OpenSourceSDRLab/ZYNQ7020-FMC/hardware/ZYNQ7020-FMC_Carrier_Schematic.pdf

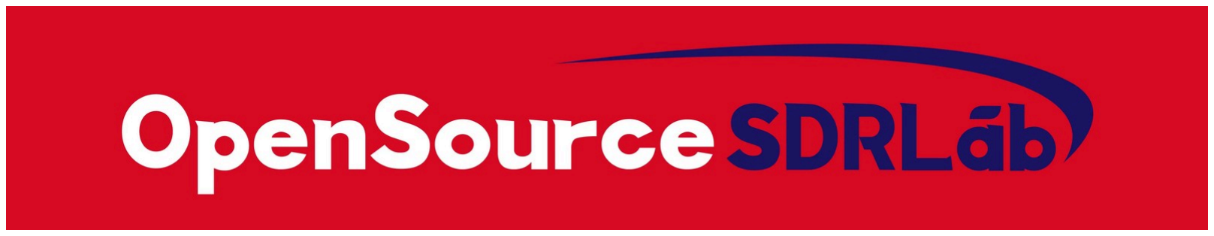
[picture p8: figure]

## © 2026 OpenSourceSDRLab. All rights reserved. · www.opensourcesdrlab.com

# OPENSOURCESDRLAB DOCUMENTATION

# ZYNQ7020-FMC Carrier Board Schematic

Product | ZYNQ7020-FMC
Document | OSSDRLAB-ZYNQ7020-FMC-SCH-CARRIER
Version | 1.1
Date | 2026-11-12

This document contains the circuit schematic of the OpenSourceSDRLab ZYNQ7020-FMC carrier board (revision V1.1), exported from Altium Designer (A4). The seven schematic sheets follow this cover page.

Sheet | Content
1 | Board-to-board connectors to the ZYNQ7020 core module (2 × 120-pin)
2 | Power: 12 V DC input jack, input protection, MP2225 and MP2145 buck regulators, FMC and I/O-bank supplies
3 | USB 2.0 OTG: USB3320C ULPI PHY, 24 MHz crystal, USB Type-C connector, TPS2051B VBUS switch
4 | Gigabit Ethernet: RTL8211F PHY (RGMII), RJ45 jack with magnetics
5 | microSD card with TXS02612 level translator, 2-position boot-mode switch, MAX809 reset supervisor, reset button, DONE LED
6 | USB-UART (CH340E, USB Type-C) with TXS0102 level translator, JTAG header, 2.54 mm expansion header (PL bank 13)
7 | FMC LPC connector (ASP-134603-01), FMC JTAG and I2C, presence detection

# Repository: https://github.com/OpenSourceSDRLab/ZYNQ7020-FMC

# Questions about the hardware: support@opensourcesdrlab.com

### COJ1

### COJ2

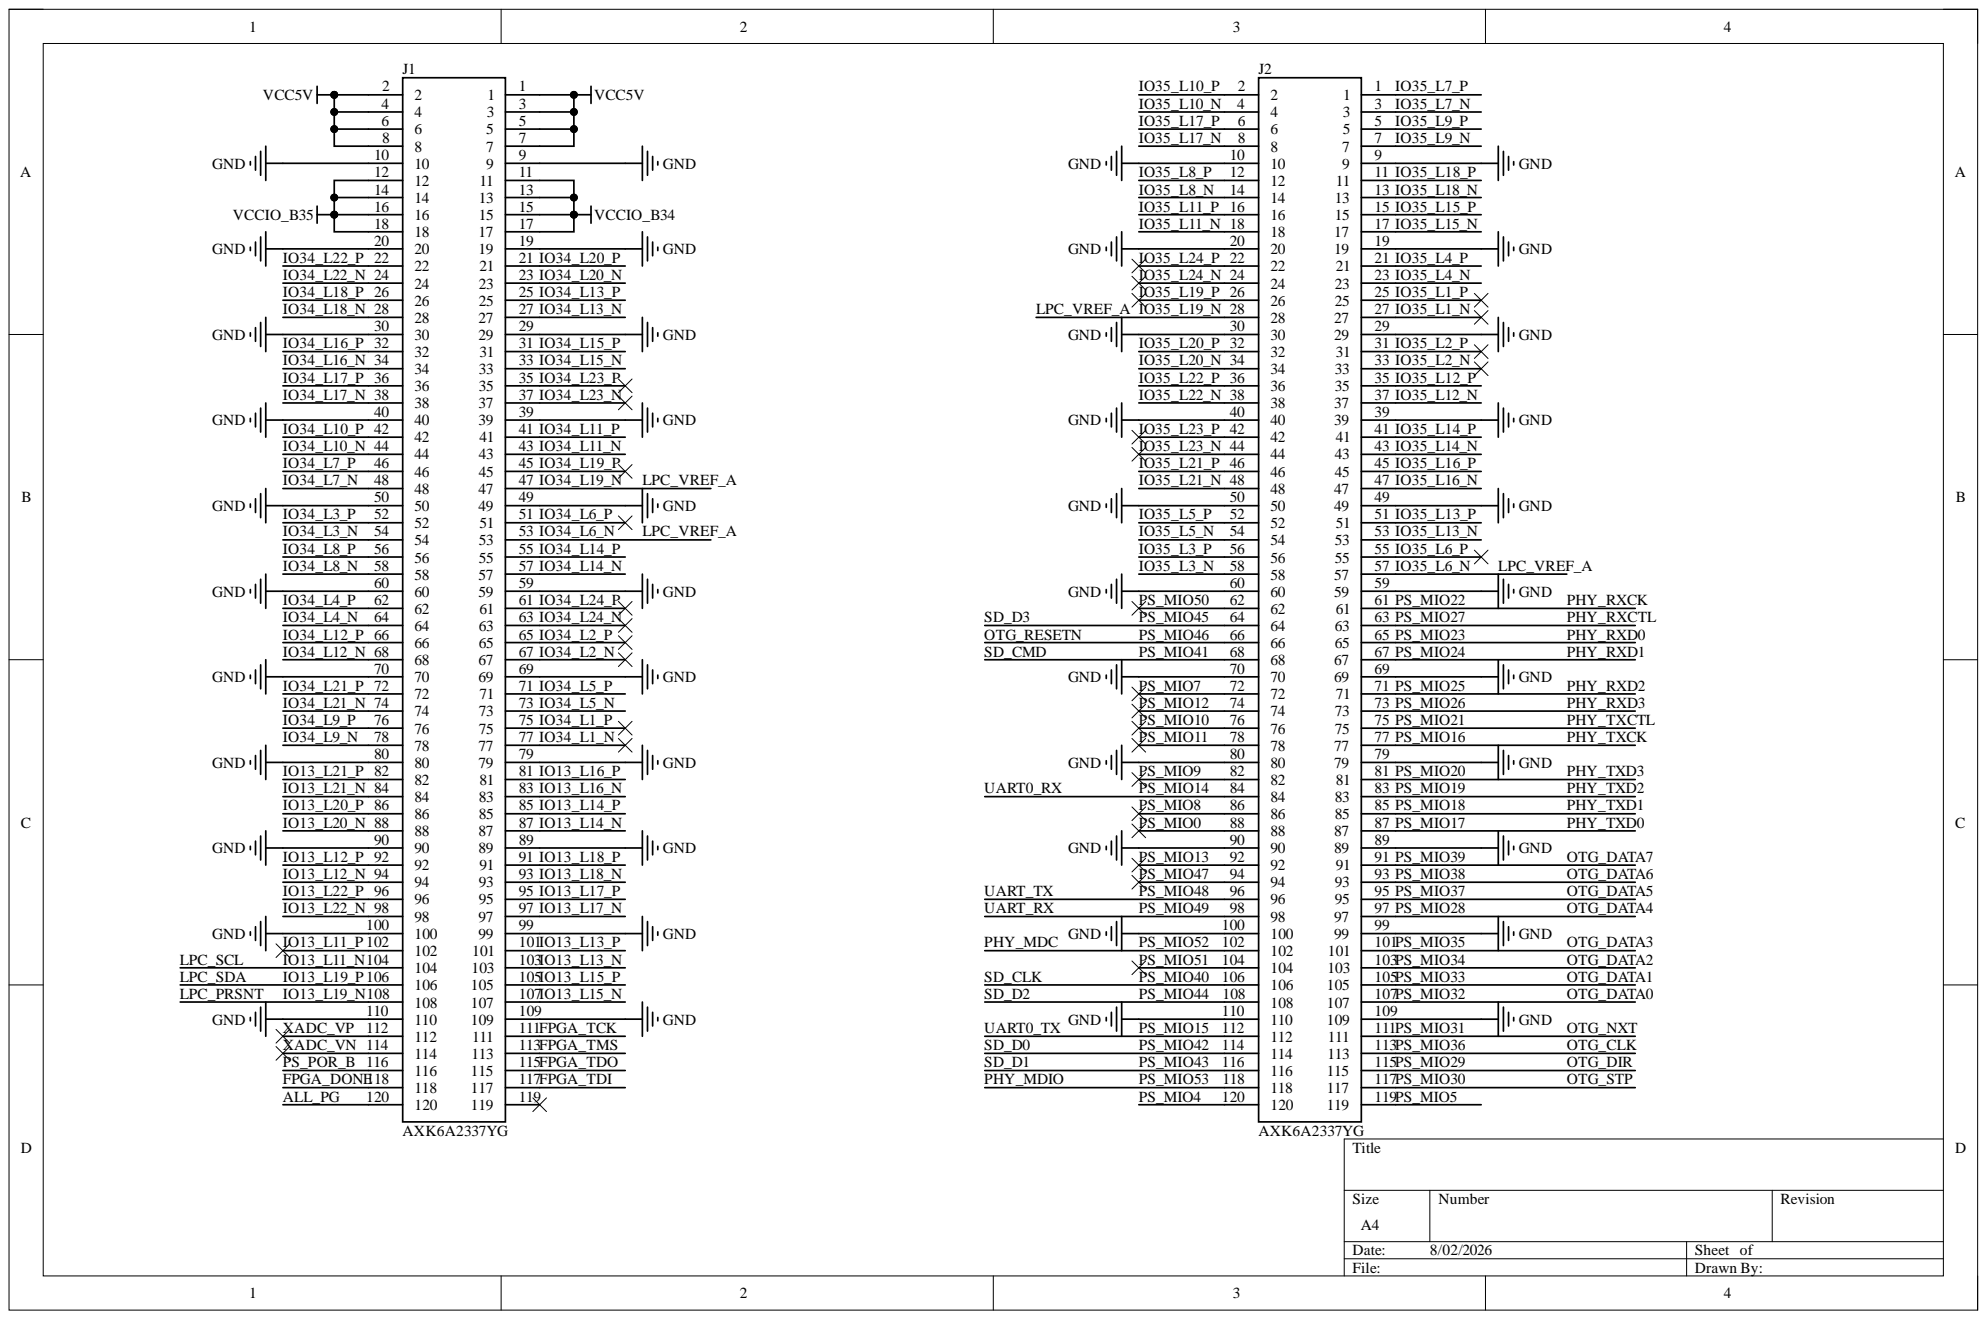
[picture p9: page 2]
Size; umb; Rev; Dat; Sheet; Draw; VCC5; PS_MIO; VCCIO; FPG; TMS; N PS_POR_; 9 PS_MIO; 8 PS_MIO; 7 PS_MIO; _RXCT; ATA; G_RESE; LPC_; VREF_; LPC_PRSN; LPC_SD; LPC_SCL; PIJ102; PIJ101; PIJ104; PIJ103; PIJ106; PIJ105; PIJ108; PIJ107; PIJ1010; PIJ109; PIJ1012; PIJ1011; PIJ1014; PIJ1013; PIJ1016; PIJ1015; PIJ1018; PIJ1017; PIJ1020; PIJ1019; PIJ1022; PIJ1021; PIJ1024; PIJ1023; PIJ1026; PIJ1025; PIJ1028; PIJ1027; PIJ1030; PIJ1029; PIJ1032; PIJ1031; PIJ1034; PIJ1033; PIJ1036; PIJ1035; PIJ1038; PIJ1037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

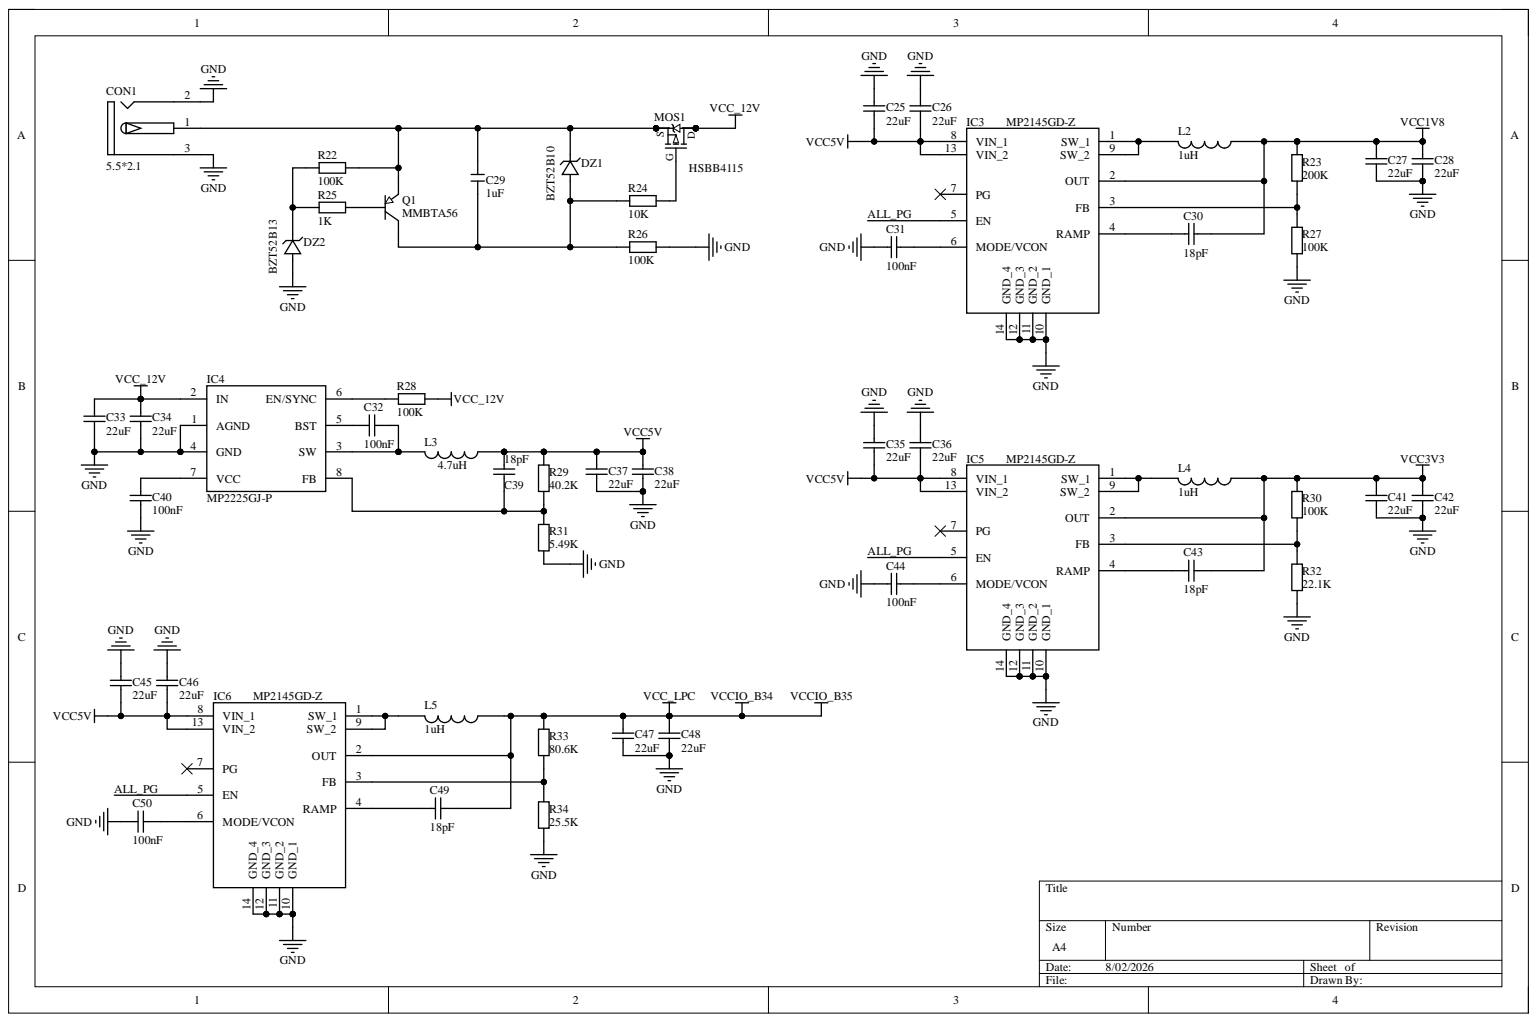
[picture p10: page 3]

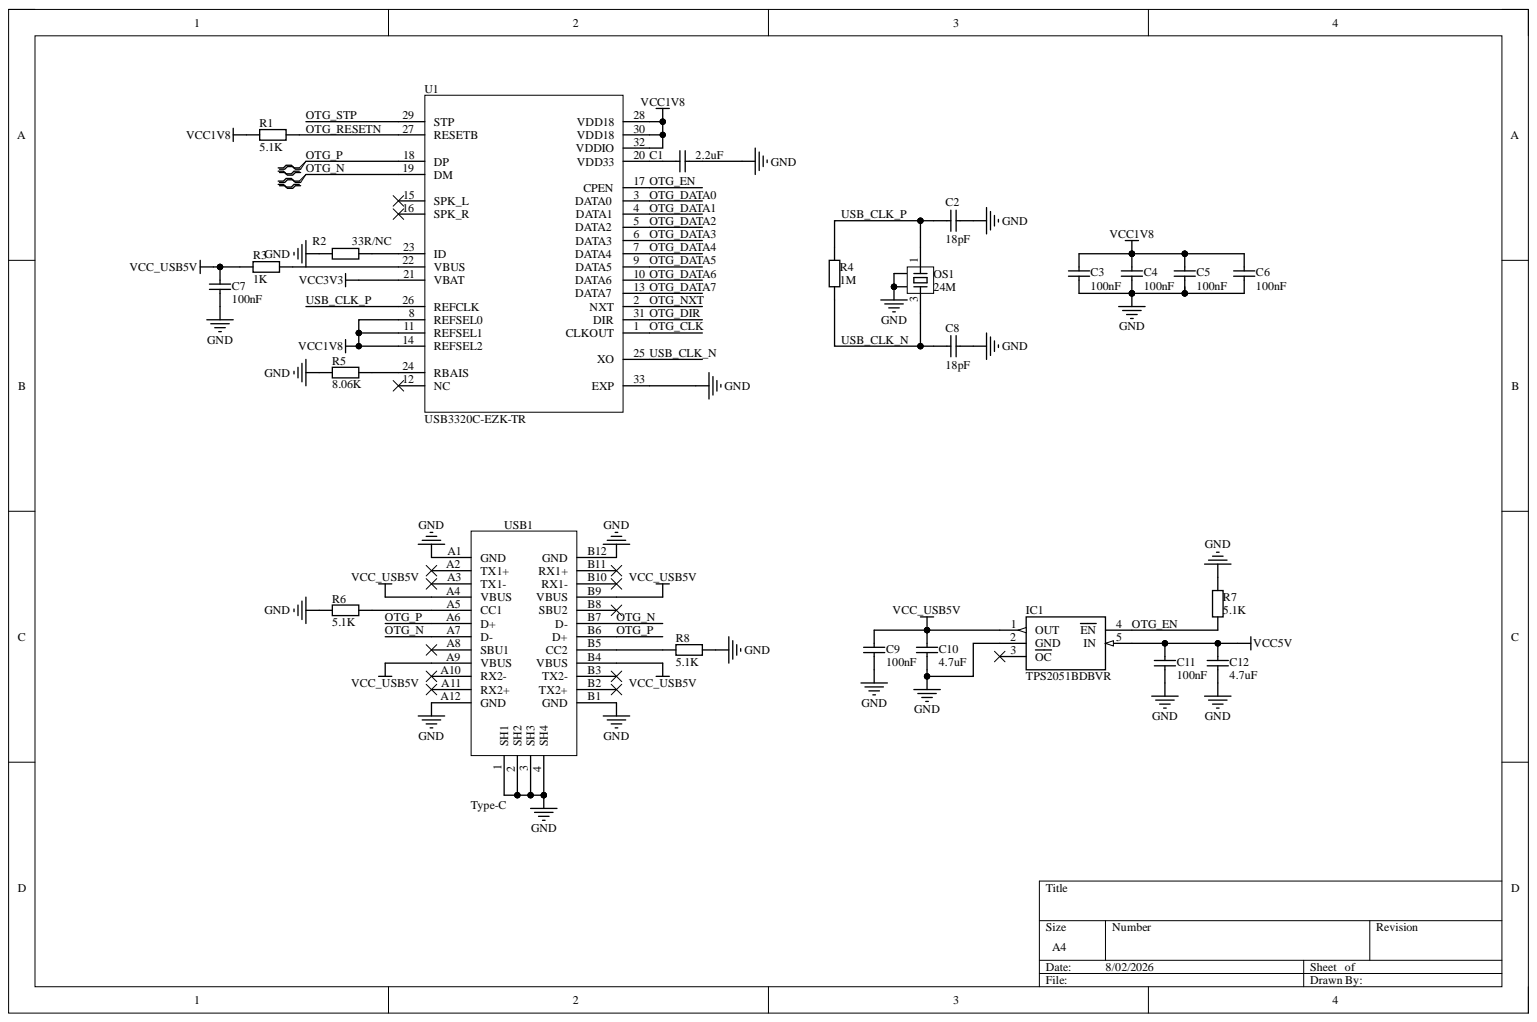
[picture p11: page 4]

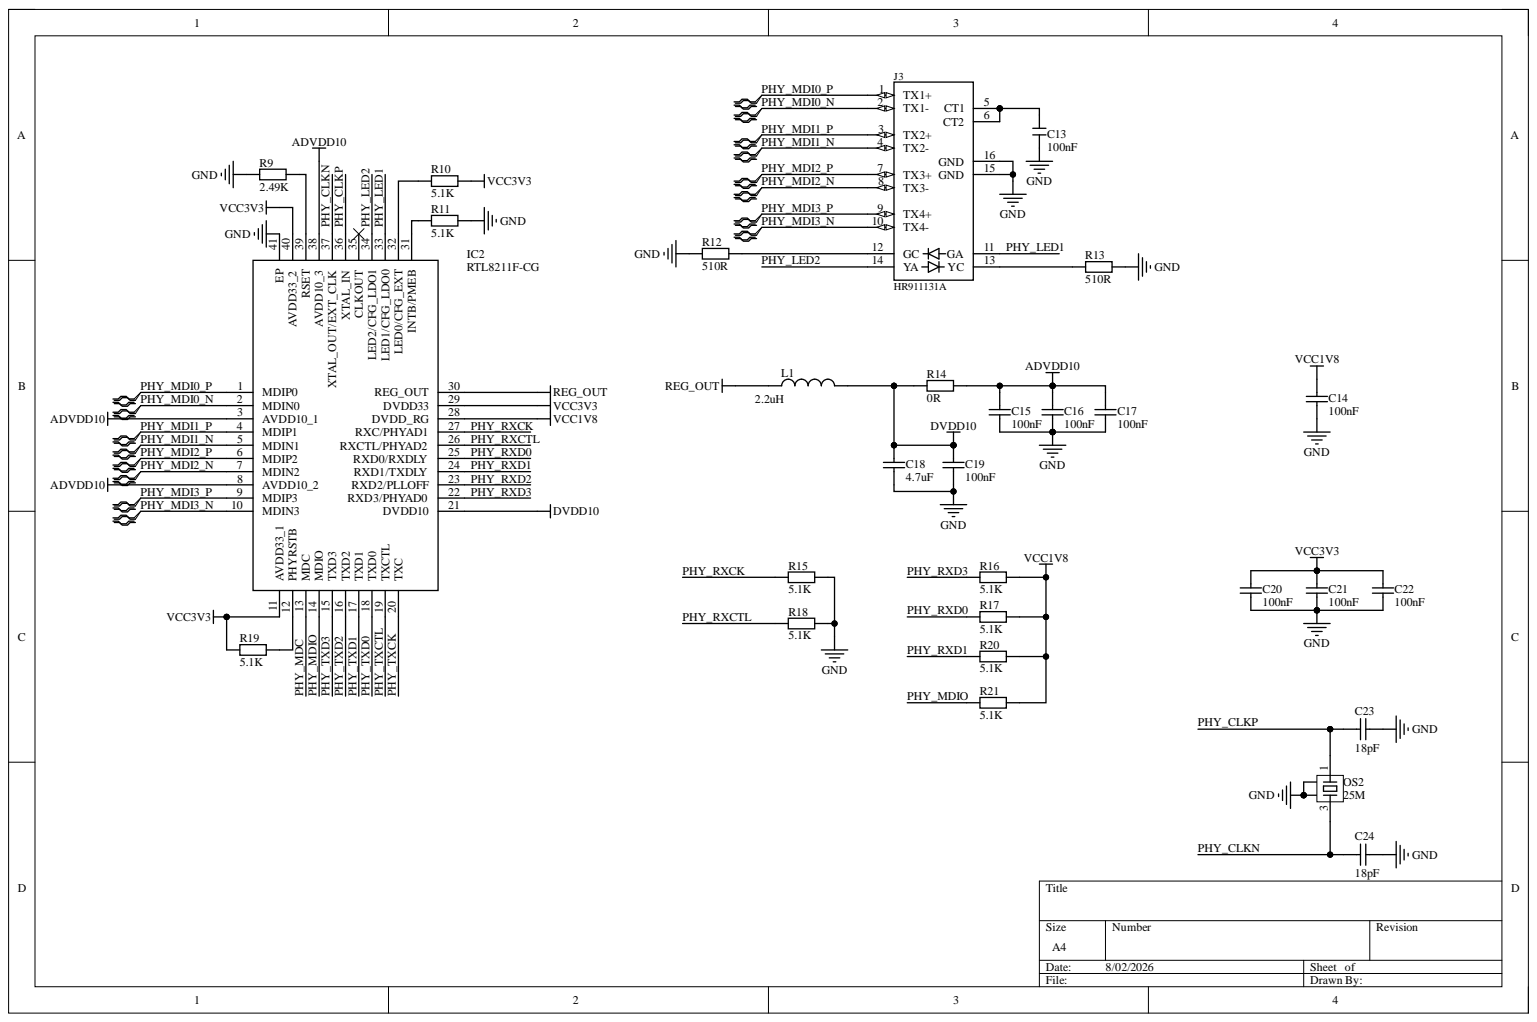
[picture p12: page 5]

## 2-position DIP switch

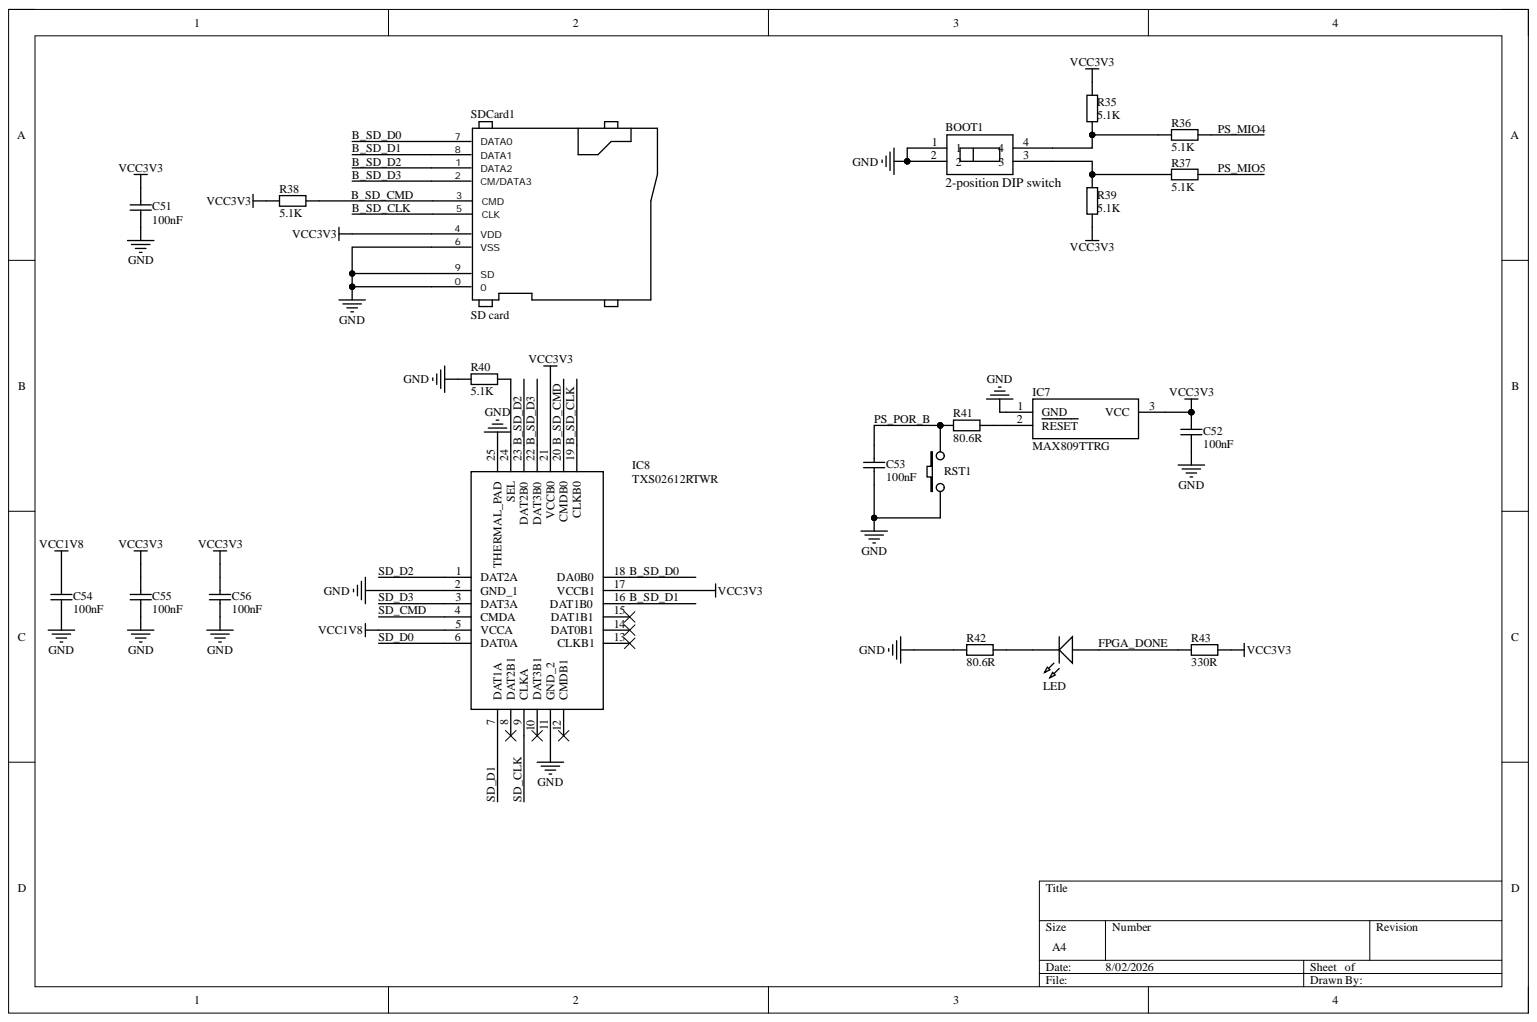
[picture p13: page 6]

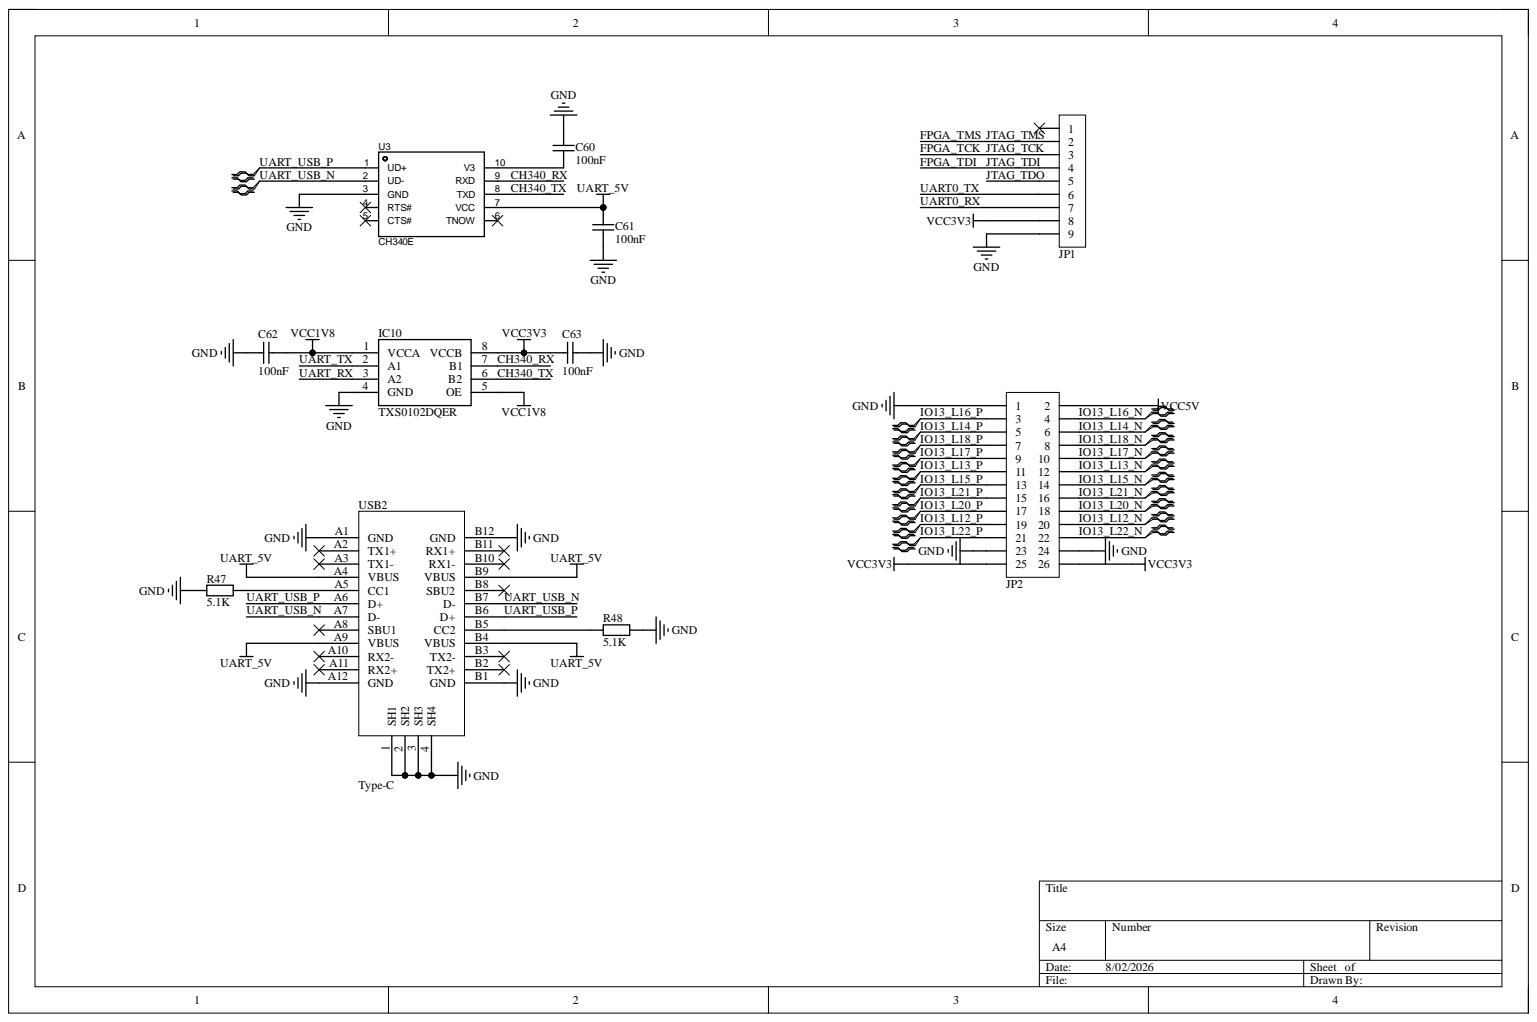
[picture p14: page 7]

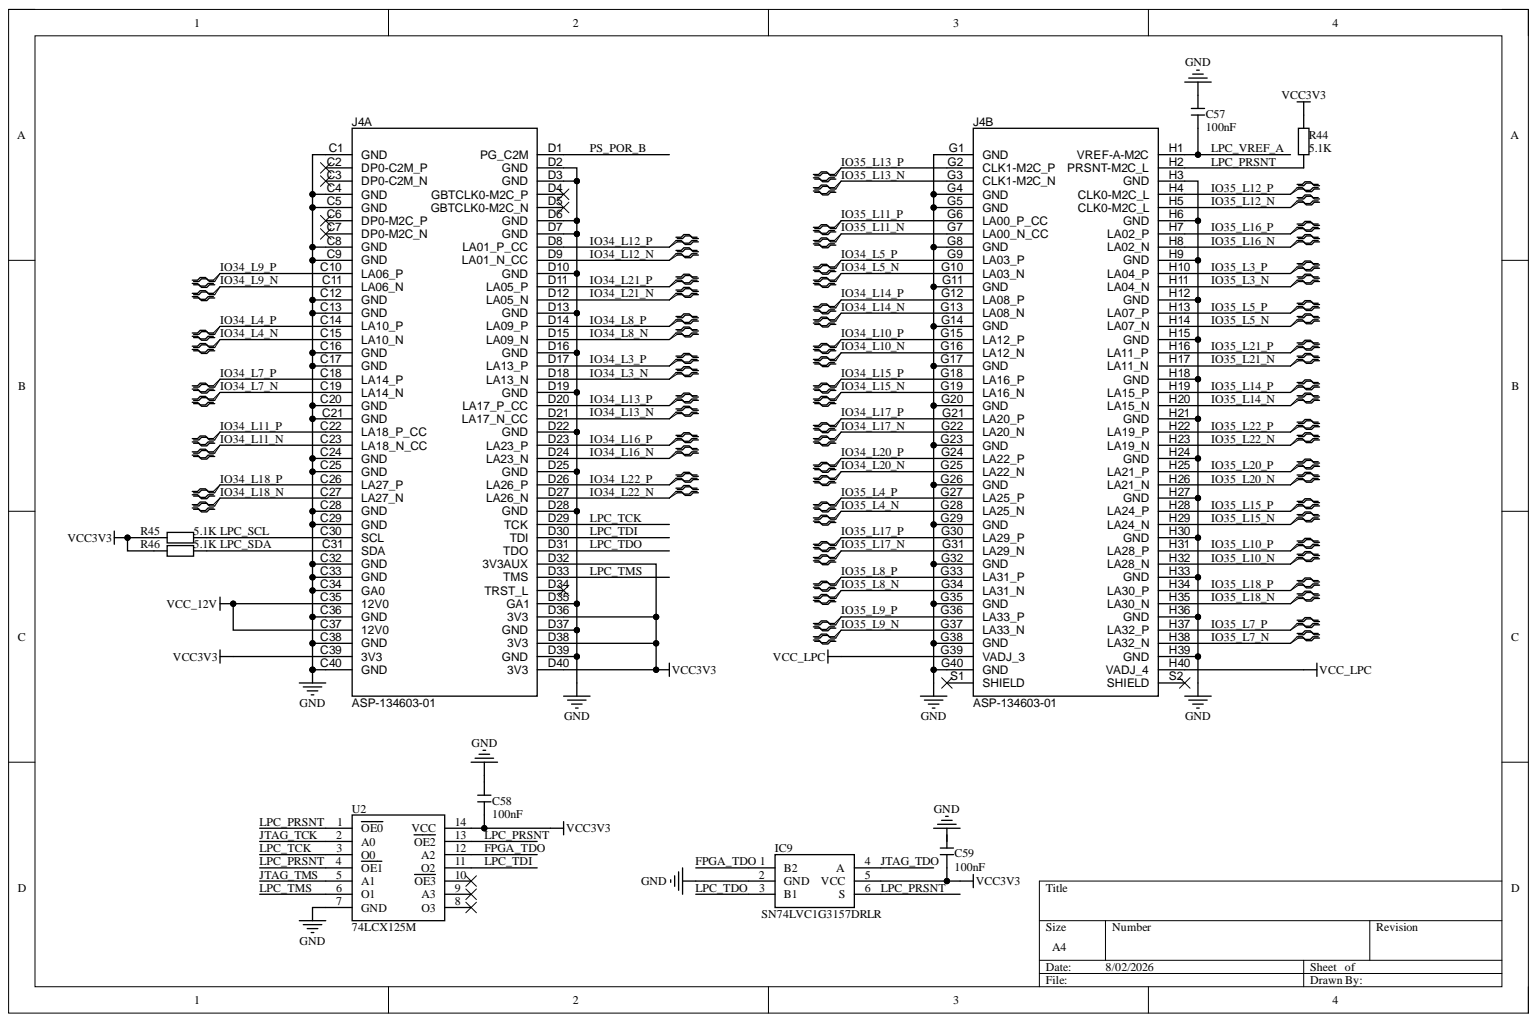
[picture p15: page 8]
Size; umb; Rev; Dat; Sheet; Draw; GBT; CLK0-M2C _; RST_L; ASP-134603-0 1; CLK1-M2C; CLK1-M2C_N G3; VADJ; VREF-A-; PRSN; VAD; PS_POR_; VCC3; LPC_; TMS; TCK; VCC_; LPC_SD; LPC_SCL; VREF_; LPC; LPC_PRSN; VCC; LCX; FPG; LVC1; RLR
