OpenSourceSDRLab/ZYNQ7020-FMC/hardware/ZYNQ7020-FMC_Core-Module_Schematic.pdf

## © 2026 OpenSourceSDRLab. All rights reserved. · www.opensourcesdrlab.com

# OPENSOURCESDRLAB DOCUMENTATION

# ZYNQ7020-FMC Core Module Schematic

Product | ZYNQ7020-FMC
Document | OSSDRLAB-ZYNQ7020-FMC-SCH-CORE
Version | 1.0
Date | 2026-11-12

# This document contains the circuit schematic of the ZYNQ7020 core module used on the OpenSourceSDRLab ZYNQ7020-FMC development board, exported from Altium Designer (A4). The

eight schematic sheets follow this cover page.

Sheet | Content
1 | Zynq configuration bank 0: JTAG, DONE / INIT_B / PROGRAM_B, XADC with REF3312 voltage reference
2 | PS MIO banks 500/501, 33.333 MHz PS clock, PS reset, W25Q256JV quad-SPI flash (32 MB), boot-mode straps
3 | PL I/O banks 13, 34 and 35
4 | PS DDR3 interface (bank 502) and TPS51200 DDR termination regulator
5 | DDR3 memory: two MT41K256M16TW (2 × 4 Gbit, 32-bit bus, 1 GB) and termination resistors
6 | Zynq power pins and decoupling
7 | Board-to-board connectors to the carrier (2 × 120-pin)
8 | Power supply: four MP2145 buck regulators, power LED

Device: Xilinx/AMD Zynq-7000 XC7Z020-2CLG400I.

# Repository: https://github.com/OpenSourceSDRLab/ZYNQ7020-FMC

# Questions about the hardware: support@opensourcesdrlab.com

0 R10 | DONE_0 R11 | TMS_0 J6 | TCK_0 F9 | TDO_0 F6 | TDI_0 G6 U1D XC7Z020-2CL

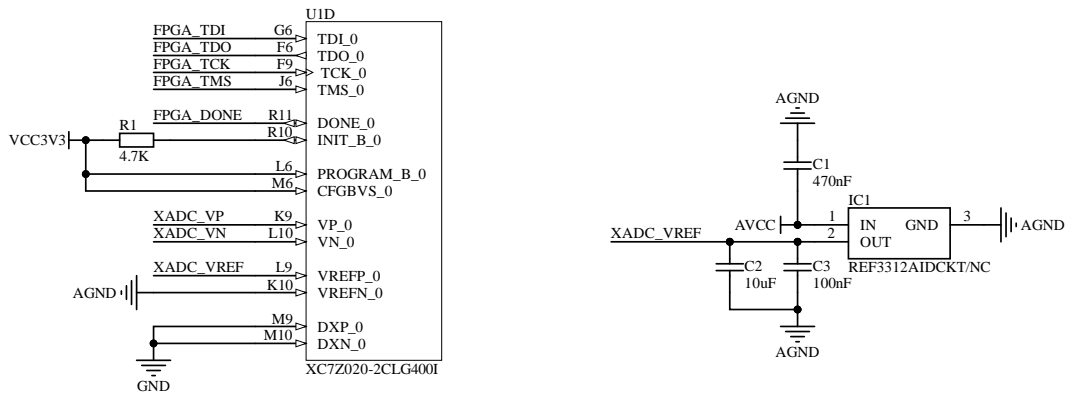
[picture p16: page 2]
Size; umb; Rev; Dat; Sheet; Draw; DXP_0 M9; VREFN; VREFP_; CFGBVS_; PROGRAM_B_; INIT; FPG; TMS; VCC3; REF3; AIDCK

R3 20K

R5 20K

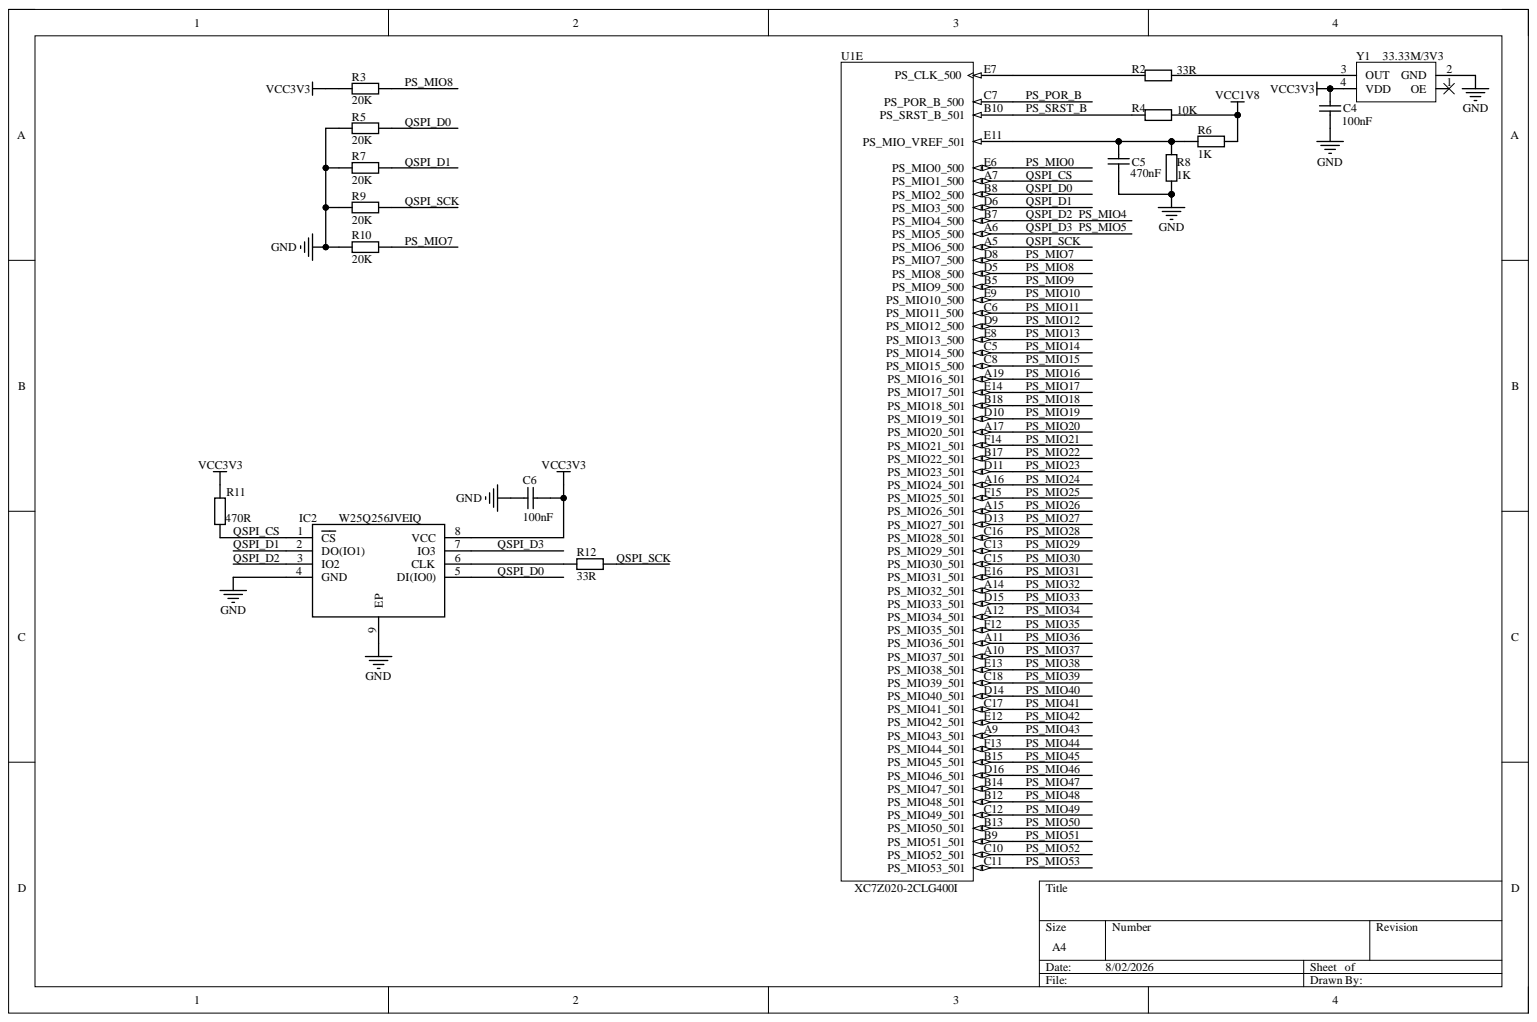
[picture p17: page 3]

9 IO_L24N_T3_34 | P16 IO_L24P_T3_34 | P15 IO_L23N_T3_34 | P18 IO_L23P_T3_34 | N17 IO_L22N_T3_34 | W19 IO_L22P_T3_34 | W18 IO_L21N_T3_DQS_34 | V18 IO_L21P_T3_DQS_34 | V17 IO_L20N_T3_34 | R18 IO_L20P_T3_34 | T17 IO_L19N_T3_VREF_34 | R17 IO_L19P_T3_34 | R16 IO_L18N_T2_34 | W16 IO_L18P_T2_34 | V16 IO_L17N_T2_34 | Y19 IO_L17P_T2_34 | Y18 IO_L16N_T2_34 | W20 IO_L16P_T2_34 | V20 IO_L15N_T2_DQS_34 | U20 IO_L15P_T2_DQS_34 | T20 IO_L14N_T2_SRCC_34 | P20 IO_L14P_T2_SRCC_34 | N20 IO_L13N_T2_MRCC_34 | P19 IO_L13P_T2_MRCC_34 | N18 IO_L12N_T1_MRCC_34 | U19 IO_L12P_T1_MRCC_34 | U18 IO_L11N_T1_SRCC_34 | U15 IO_L11P_T1_SRCC_34 | U14 IO_L10N_T1_34 | W15 IO_L10P_T1_34 | V15 IO_L9N_T1_DQS_34 | U17 IO_L9P_T1_DQS_34 | T16 IO_L8N_T1_34 | Y14 IO_L8P_T1_34 | W14 IO_L7N_T1_34 | Y17 IO_L7P_T1_34 | Y16 IO_L6N_T0_VREF_34 | R14 IO_L6P_T0_34 | P14 IO_L5N_T0_34 | T15 IO_L5P_T0_34 | T14 IO_L4N_T0_34 | W13 IO_L4P_T0_34 | V12 IO_L3N_T0_DQS_34 | V13 IO_L3P_T0_DQS_PUDC_B_34 | U13 IO_L2N_T0_34 | U12 IO_L2P_T0_34 | T12 IO_L1N_T0_34 | T10 IO_L1P_T0_34 | T11 IO_0_34 | R19
5 IO_L24N_T3_AD15N_35 | J16 IO_L24P_T3_AD15P_35 | K16 IO_L23N_T3_35 | M15 IO_L23P_T3_35 | M14 IO_L22N_T3_AD7N_35 | L15 IO_L22P_T3_AD7P_35 | L14 IO_L21N_T3_DQS_AD14N_35 | N16 IO_L21P_T3_DQS_AD14P_35 | N15 IO_L20N_T3_AD6N_35 | J14 IO_L20P_T3_AD6P_35 | K14 IO_L19N_T3_VREF_35 | G15 IO_L19P_T3_35 | H15 IO_L18N_T2_AD13N_35 | G20 IO_L18P_T2_AD13P_35 | G19 IO_L17N_T2_AD5N_35 | H20 IO_L17P_T2_AD5P_35 | J20 IO_L16N_T2_35 | G18 IO_L16P_T2_35 | G17 IO_L15N_T2_DQS_AD12N_35 | F20 IO_L15P_T2_DQS_AD12P_35 | F19 IO_L14N_T2_AD4N_SRCC_35 | H18 IO_L14P_T2_AD4P_SRCC_35 | J18 IO_L13N_T2_MRCC_35 | H17 IO_L13P_T2_MRCC_35 | H16 IO_L12N_T1_MRCC_35 | K18 IO_L12P_T1_MRCC_35 | K17 IO_L11N_T1_SRCC_35 | L17 IO_L11P_T1_SRCC_35 | L16 IO_L10N_T1_AD11N_35 | J19 IO_L10P_T1_AD11P_35 | K19 IO_L9N_T1_DQS_AD3N_35 | L20 IO_L9P_T1_DQS_AD3P_35 | L19 IO_L8N_T1_AD10N_35 | M18 IO_L8P_T1_AD10P_35 | M17 IO_L7N_T1_AD2N_35 | M20 IO_L7P_T1_AD2P_35 | M19 IO_L6N_T0_VREF_35 | F17 IO_L6P_T0_35 | F16 IO_L5N_T0_AD9N_35 | E19 IO_L5P_T0_AD9P_35 | E18 IO_L4N_T0_35 | D20 IO_L4P_T0_35 | D19 IO_L3N_T0_DQS_AD1N_35 | D18 IO_L3P_T0_DQS_AD1P_35 | E17 IO_L2N_T0_AD8N_35 | A20 IO_L2P_T0_AD8P_35 | B19 IO_L1N_T0_AD0N_35 | B20 IO_L1P_T0_AD0P_35 | C20 IO_0_35 | G14

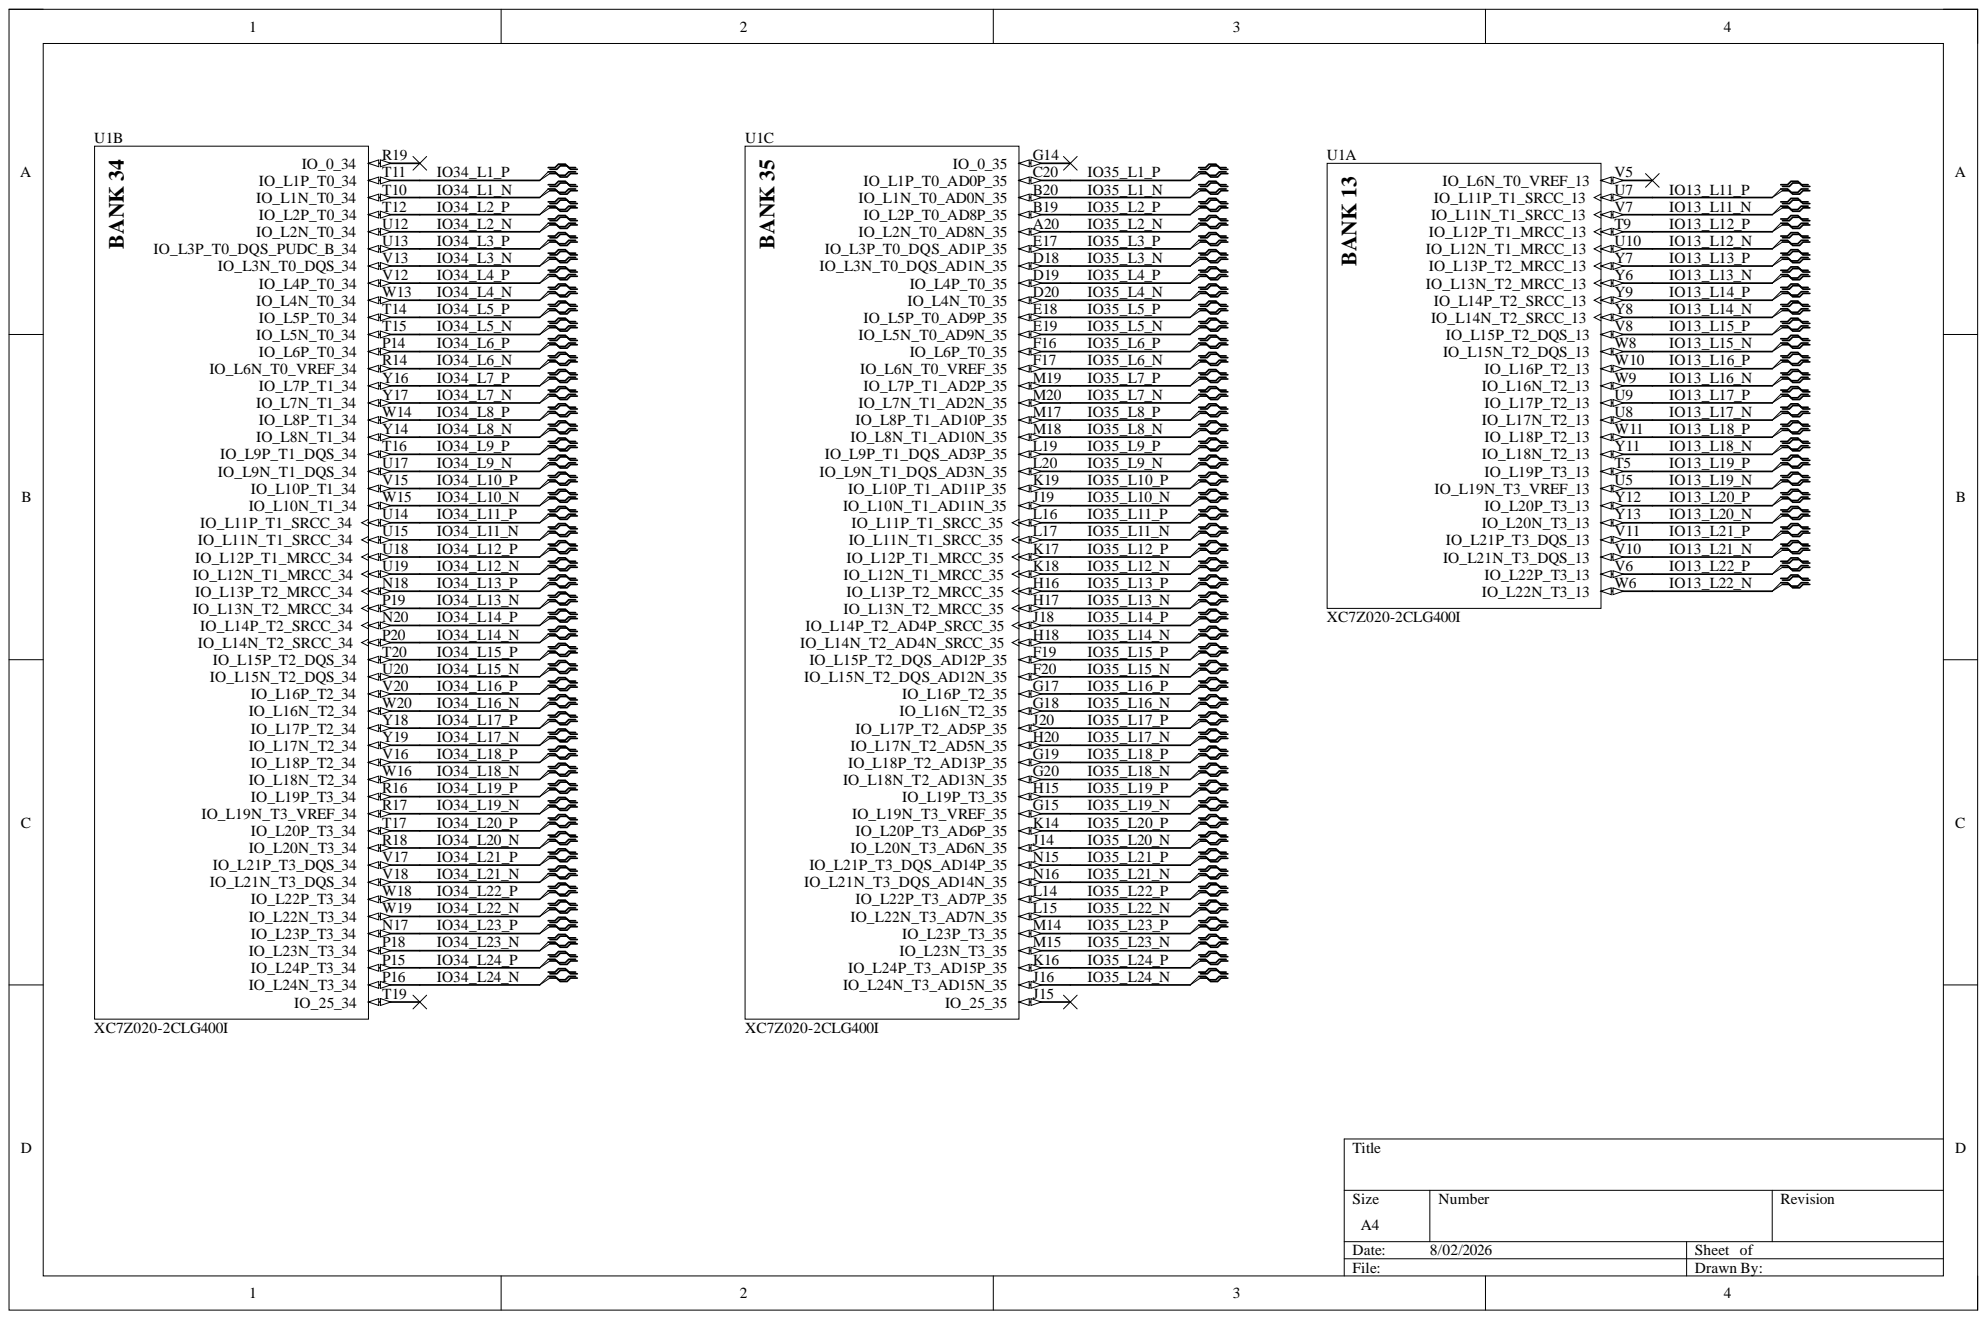
[picture p18: page 4]
Size; umb; Rev; V6 IO_L21N_T3_DQS_13; V10 IO_L21P_T3_DQS_13; Y12 IO_L19N_T3_VREF_13; W10 IO_L15N_T2_DQS_13; W8 IO_L15P_T2_DQS_13; V8 IO_L14N_T2_SRCC_13; Y8 IO_L14P_T2_SRCC_13; Y9 IO_L13N_T2_MRCC_13; Y6 IO_L13P_T2_MRCC_13; Y7 IO_L12N_T1_MRCC_13; U10 IO_L12P_T1_MRCC_13; T9 IO_L11N_T1_SRCC_13; V7 IO_L11P_T1_SRCC_13; U7 IO_L6N_T0_VREF_13; BANK 13; BANK 34; BANK 35; PIU10T5; PIU10T9; PIU10U5; PIU10U7; PIU10U8; PIU10U9; PIU10U10; PIU10V5; PIU10V6; PIU10V7; PIU10V8; PIU10V10; PIU10V11; PIU10W6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

# FXC7

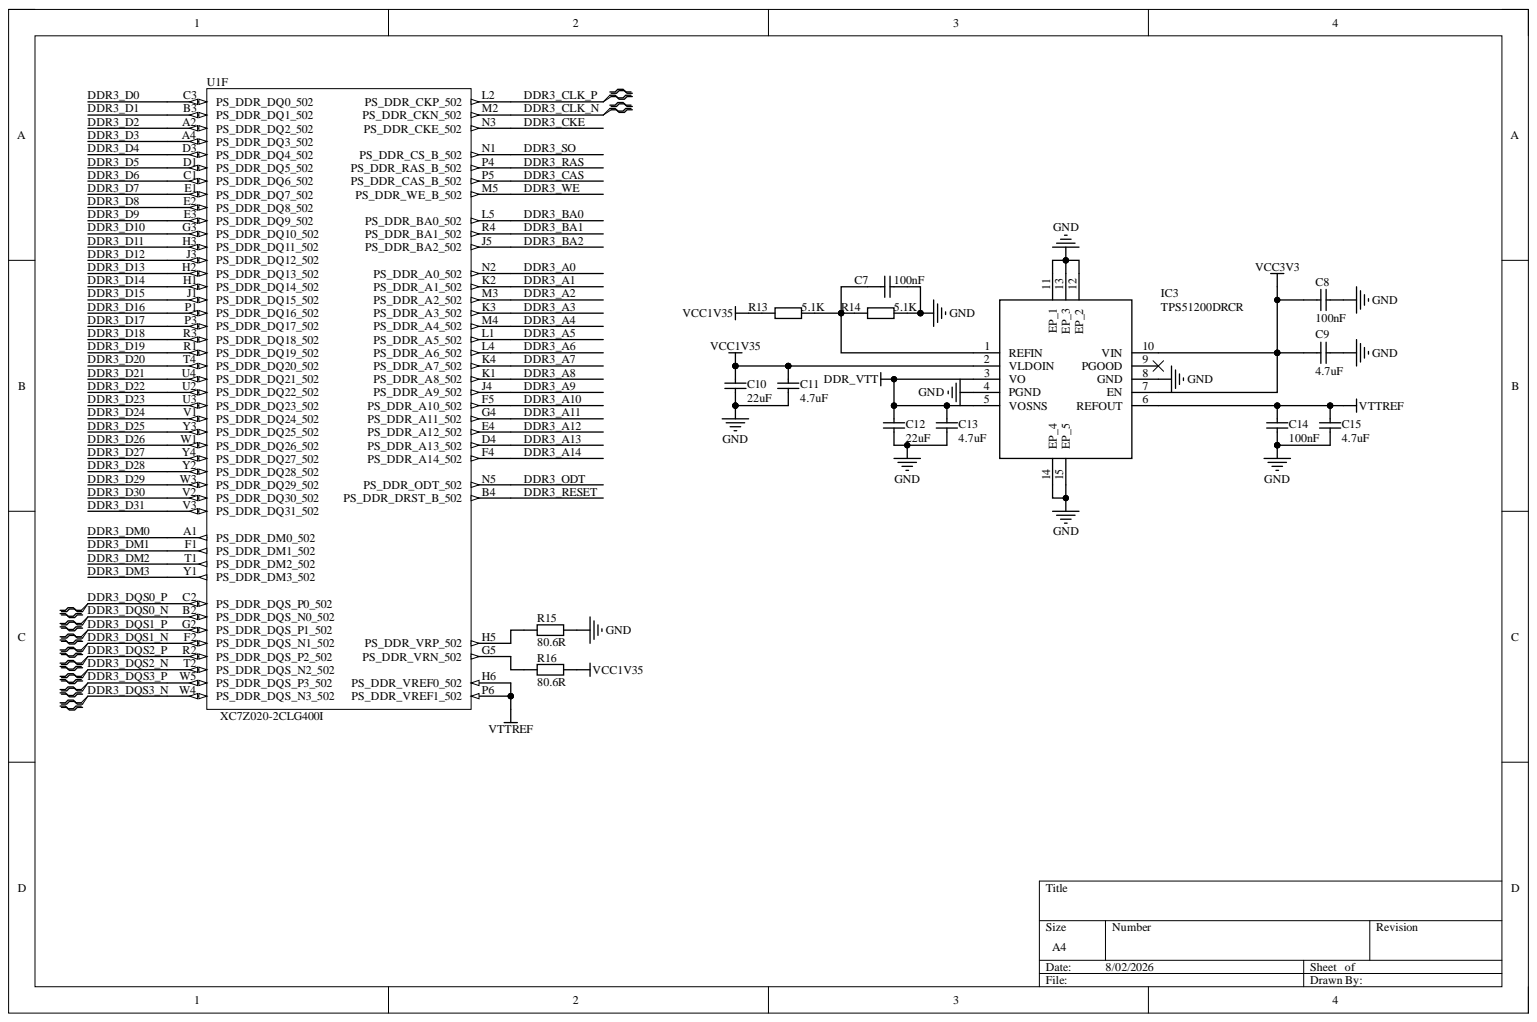
[picture p19: page 5]

# U2MT41K256M16T

# K_ND

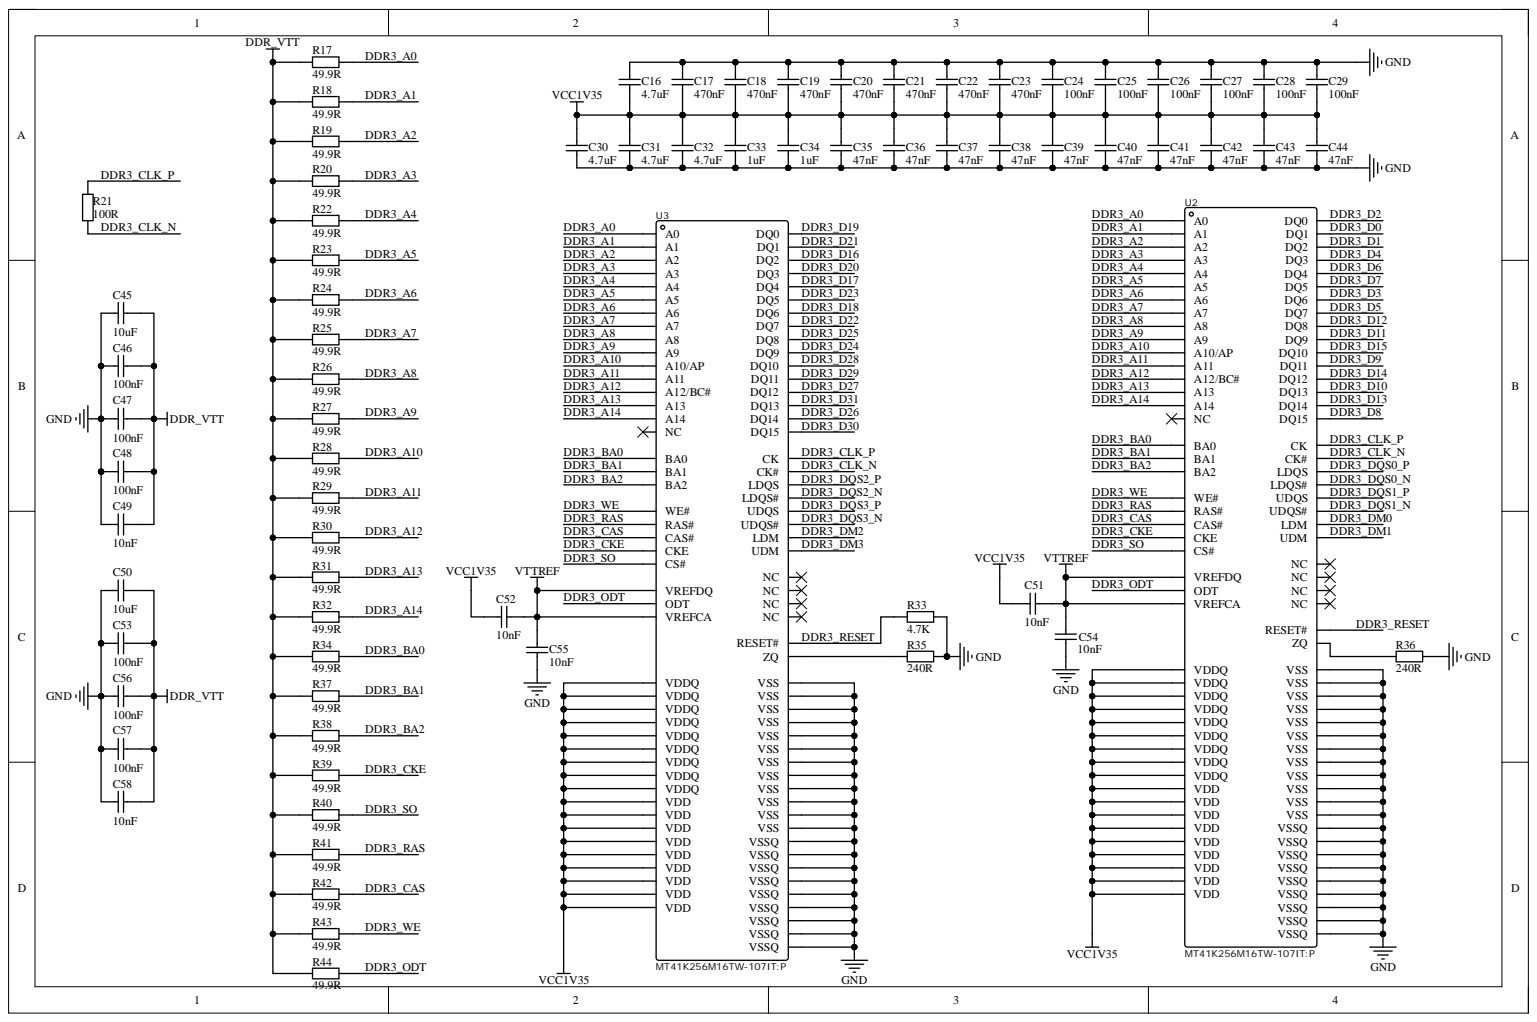
[picture p20: page 6]

GND | Y15 GND | Y5 GND | W12 GND | W2 GND | V19 GND | V9 GND | U16 GND | U6 GND | T13 GND | T7 GND | T3 GND | R20 GND | R12 GND | R8 GND | P17 GND | P13 GND | P11 GND | P9 GND | P7 GND | N14 GND | N12 GND | N10 GND | N8 GND | N4 GND | M13 GND | M11 GND | M7 GND | M1
GND K11 | GND K7 | GND K5 | GND J12 | GND J8 | GND J2 | GND H19 | GND H13 | GND H11 | GND H9 | GND H7 | GND G16 | GND G12 | GND G10 | GND F7 | GND F3 | GND E20 | GND E10 | GND D17 | GND C14 | GND C9 | GND C4 | GND B11 | GND B1 | GND A18 | GND A8

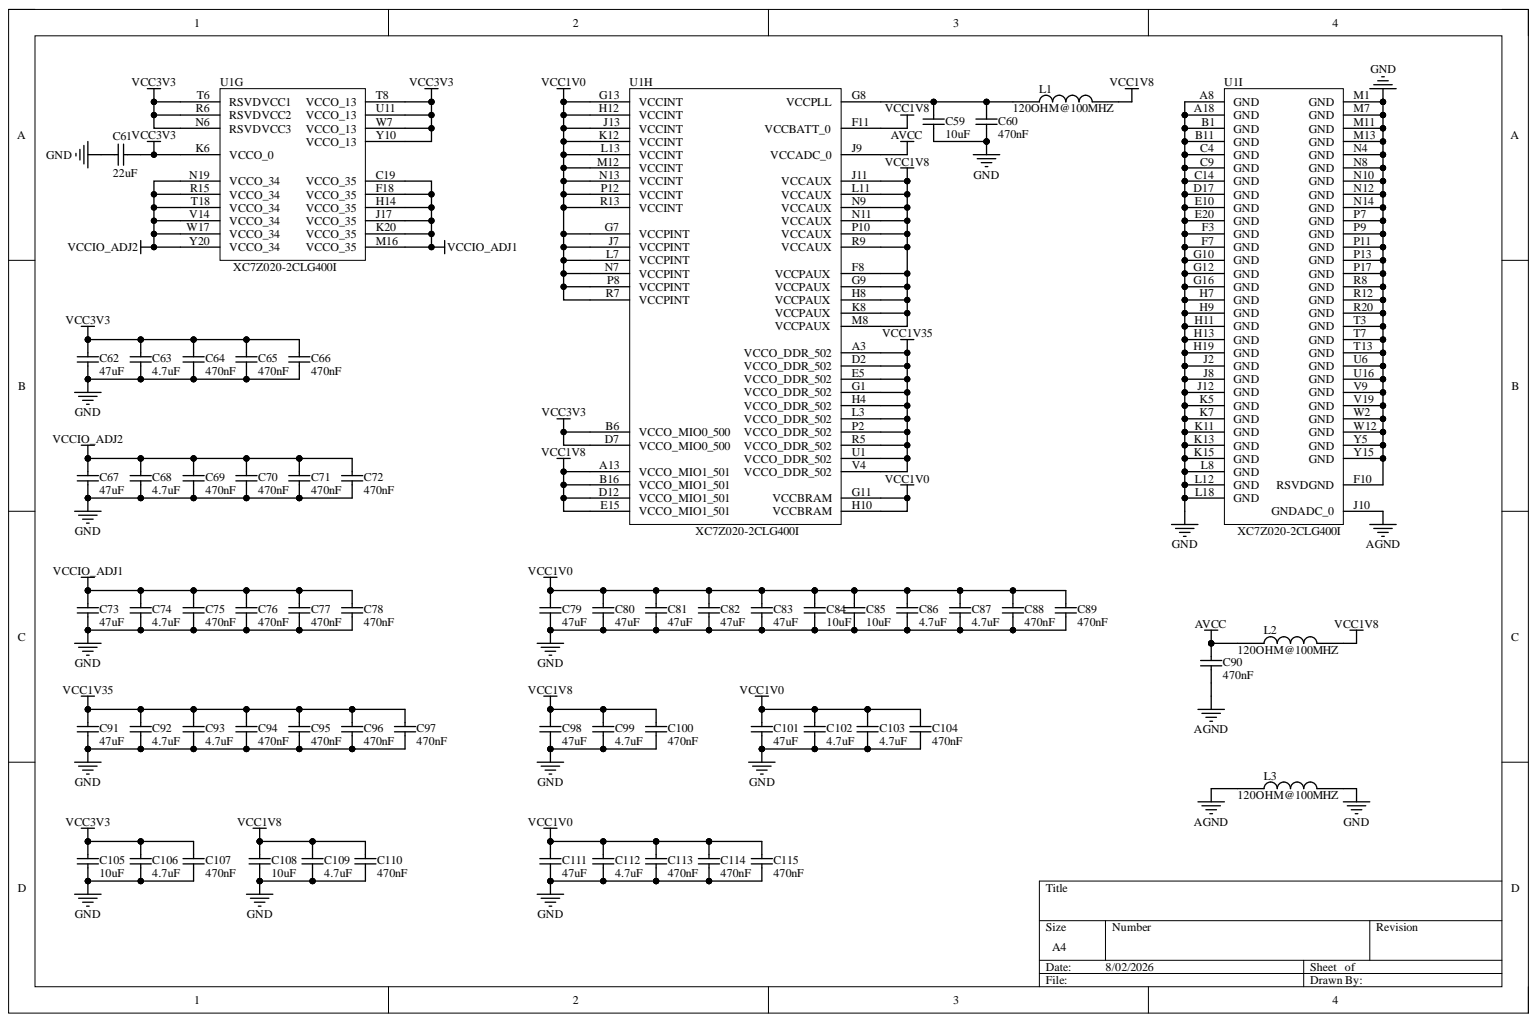
[picture p21: page 7]

### COJ1 COJ2

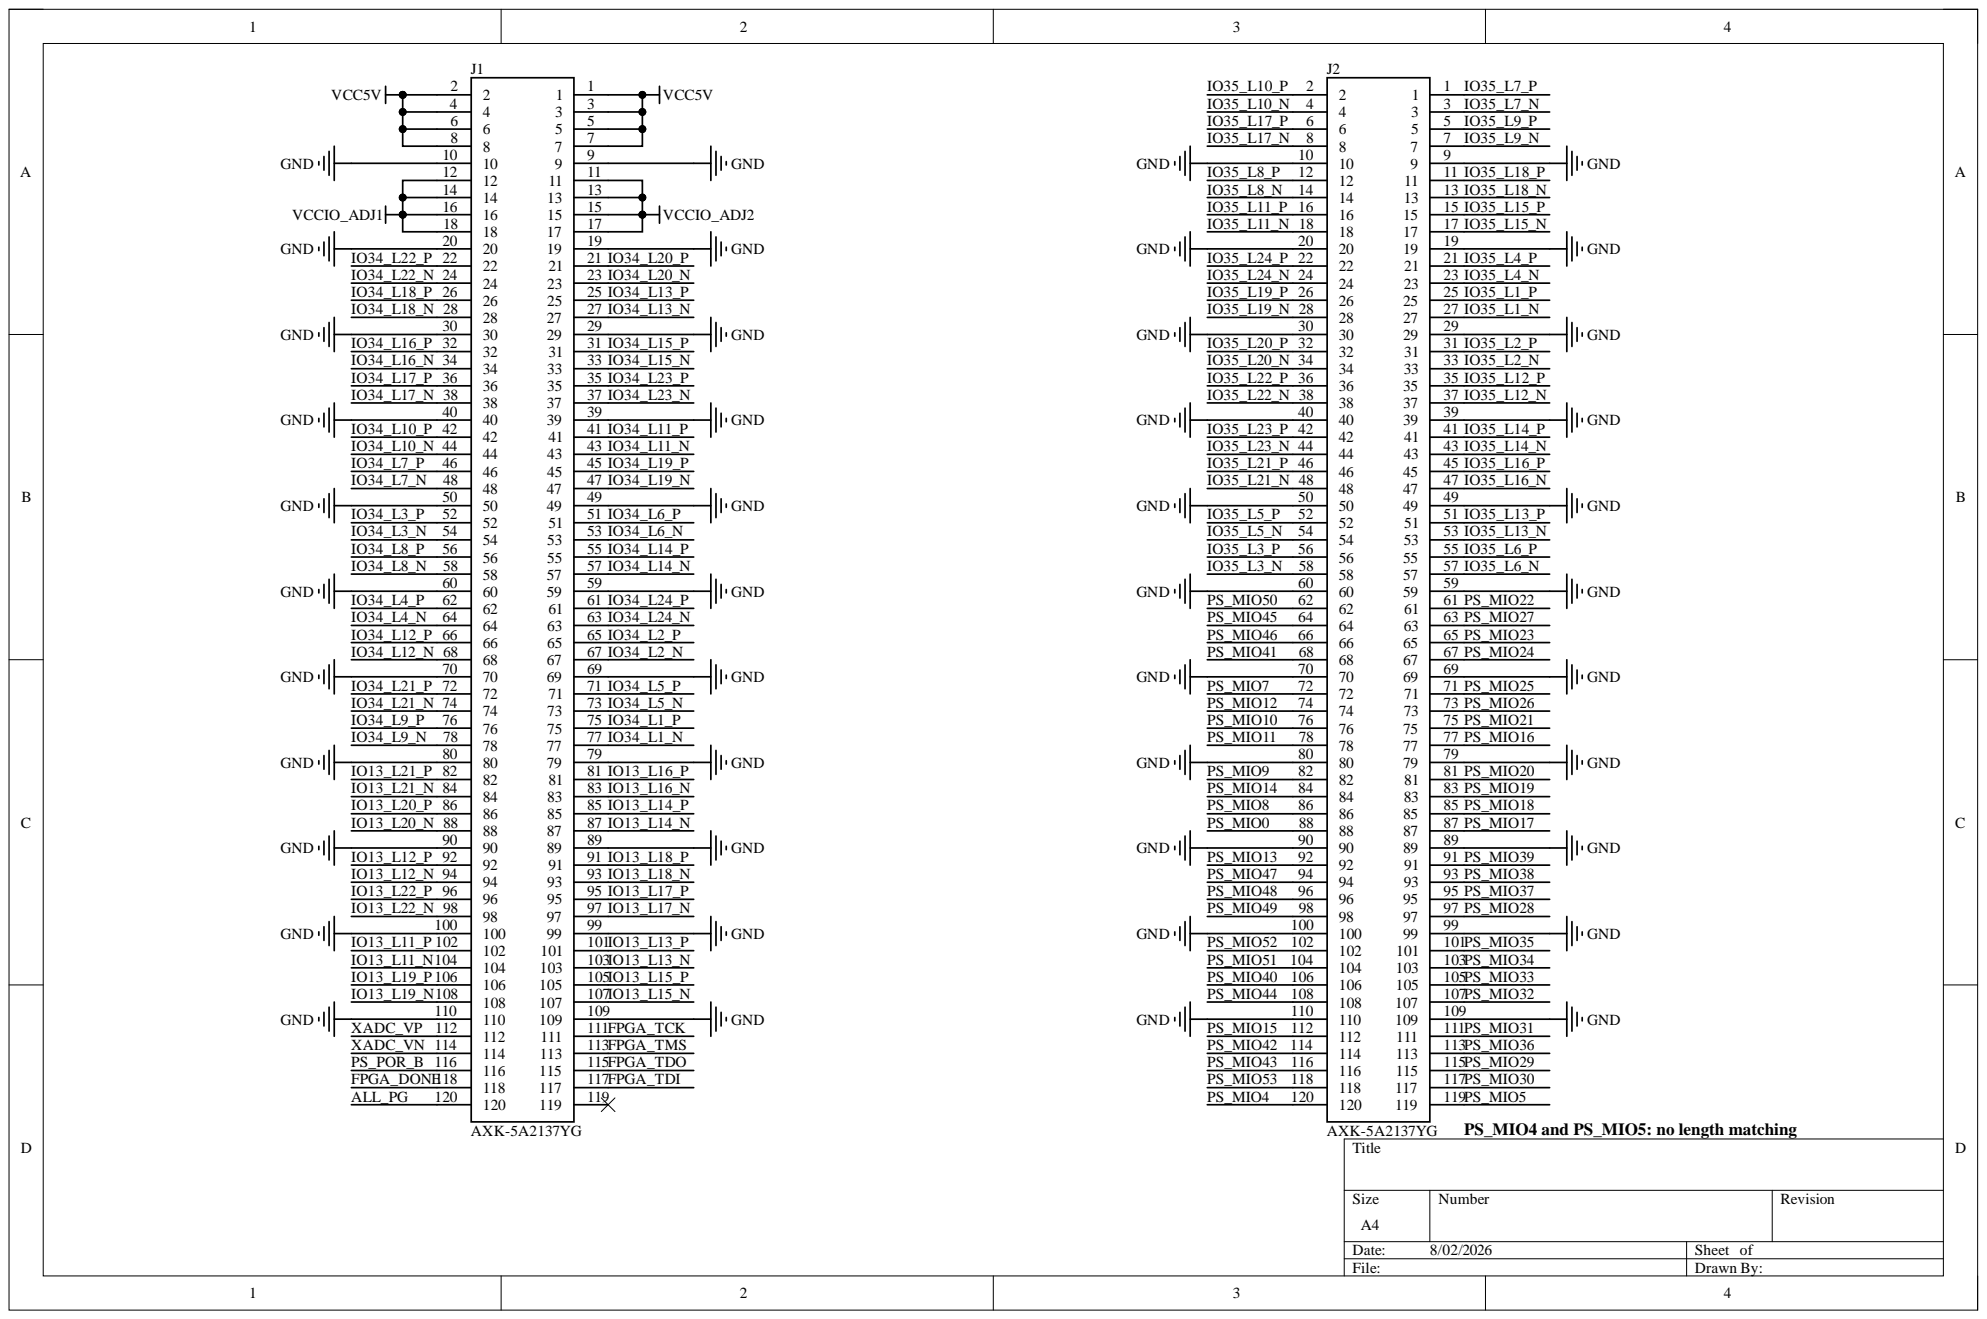
[picture p22: page 8]
Size; umb; Rev; VCC5; PS_MIO; 9 PS_MIO; 8 PS_MIO; 7 PS_MIO; VCCIO; FPG; N PS_POR_; TMS; PIJ102; PIJ101; PIJ104; PIJ103; PIJ106; PIJ105; PIJ108; PIJ107; PIJ1010; PIJ109; PIJ1012; PIJ1011; PIJ1014; PIJ1013; PIJ1016; PIJ1015; PIJ1018; PIJ1017; PIJ1020; PIJ1019; PIJ1022; PIJ1021; PIJ1024; PIJ1023; PIJ1026; PIJ1025; PIJ1028; PIJ1027; PIJ1030; PIJ1029; PIJ1032; PIJ1031; PIJ1034; PIJ1033; PIJ1036; PIJ1035; PIJ1038; PIJ1037; PIJ1040; PIJ1039; PIJ1042; PIJ1041; PIJ1044; PIJ1043; PIJ1046; PIJ1045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

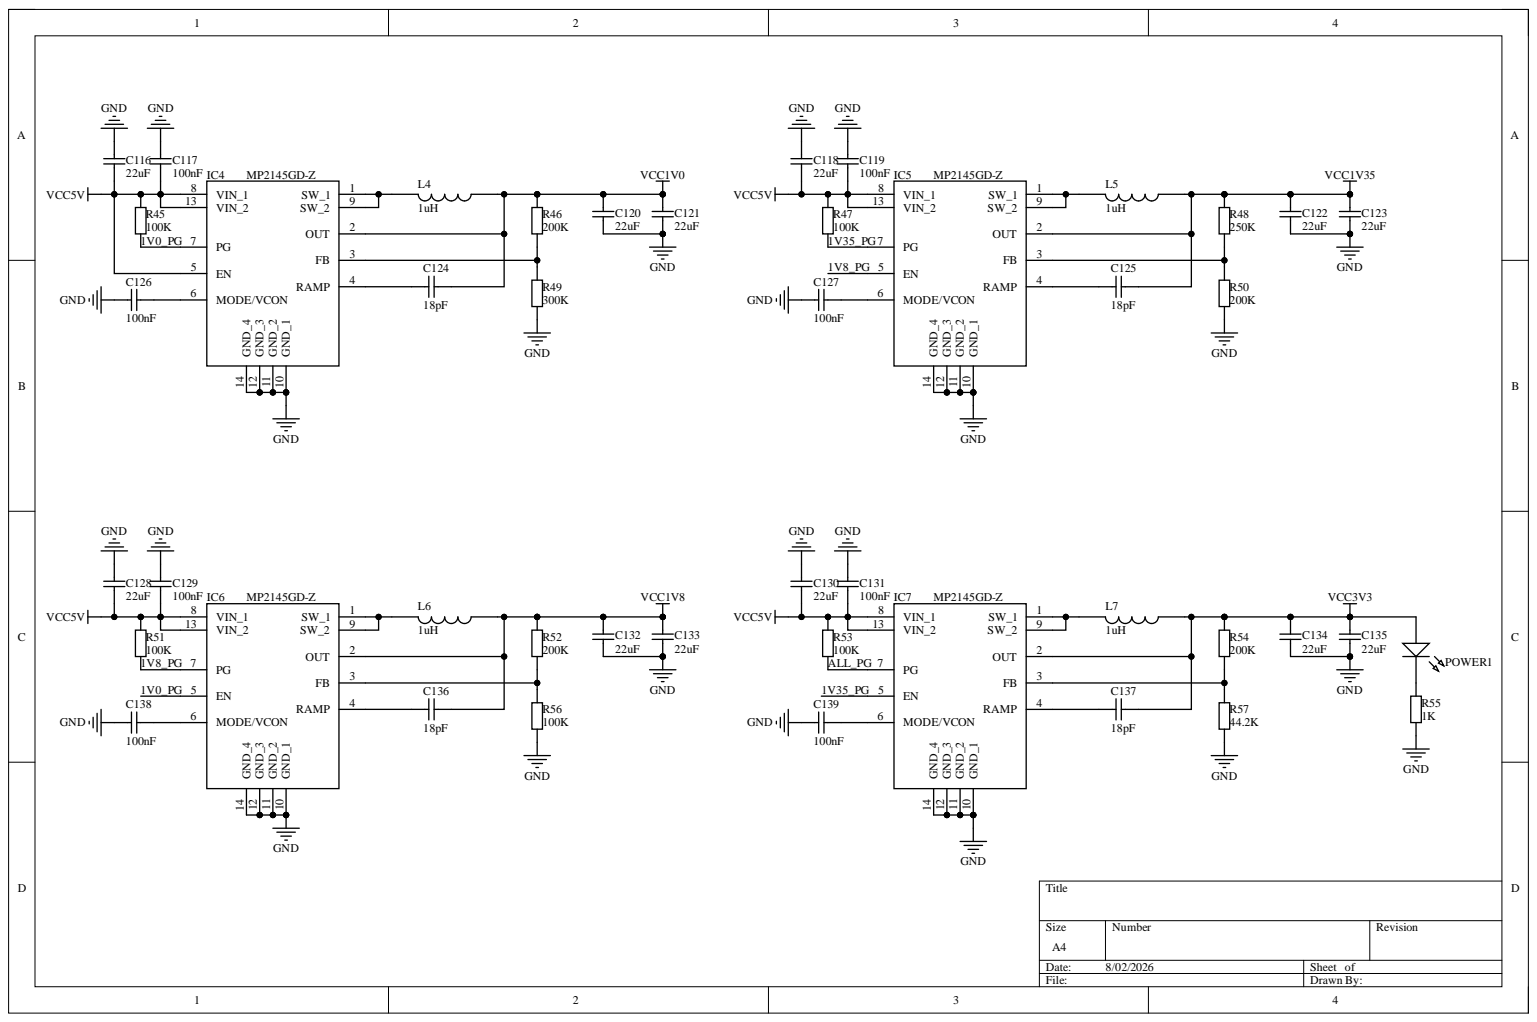
[picture p23: page 9]
