OpenSourceSDRLab/ZYNQ7020-FMC/vivado/AD936X/AD936X_PL/projects/fmcomms2/zc702/zc702.srcs/constrs_1/imports/projects/fmcomms2/zc702/system_constr.xdc

# constraints
# ad9361

set_property -dict {PACKAGE_PIN L16 IOSTANDARD LVDS_25 DIFF_TERM 1} [get_ports rx_clk_in_p]
set_property -dict {PACKAGE_PIN L17 IOSTANDARD LVDS_25 DIFF_TERM 1} [get_ports rx_clk_in_n]
set_property -dict {PACKAGE_PIN U18 IOSTANDARD LVDS_25 DIFF_TERM 1} [get_ports rx_frame_in_p]
set_property -dict {PACKAGE_PIN U19 IOSTANDARD LVDS_25 DIFF_TERM 1} [get_ports rx_frame_in_n]
set_property -dict {PACKAGE_PIN G17 IOSTANDARD LVDS_25 DIFF_TERM 1} [get_ports {rx_data_in_p[0]}]
set_property -dict {PACKAGE_PIN G18 IOSTANDARD LVDS_25 DIFF_TERM 1} [get_ports {rx_data_in_n[0]}]
set_property -dict {PACKAGE_PIN T14 IOSTANDARD LVDS_25 DIFF_TERM 1} [get_ports {rx_data_in_p[1]}]
set_property -dict {PACKAGE_PIN T15 IOSTANDARD LVDS_25 DIFF_TERM 1} [get_ports {rx_data_in_n[1]}]
set_property -dict {PACKAGE_PIN E17 IOSTANDARD LVDS_25 DIFF_TERM 1} [get_ports {rx_data_in_p[2]}]
set_property -dict {PACKAGE_PIN D18 IOSTANDARD LVDS_25 DIFF_TERM 1} [get_ports {rx_data_in_n[2]}]
set_property -dict {PACKAGE_PIN V17 IOSTANDARD LVDS_25 DIFF_TERM 1} [get_ports {rx_data_in_p[3]}]
set_property -dict {PACKAGE_PIN V18 IOSTANDARD LVDS_25 DIFF_TERM 1} [get_ports {rx_data_in_n[3]}]
set_property -dict {PACKAGE_PIN T16 IOSTANDARD LVDS_25 DIFF_TERM 1} [get_ports {rx_data_in_p[4]}]
set_property -dict {PACKAGE_PIN U17 IOSTANDARD LVDS_25 DIFF_TERM 1} [get_ports {rx_data_in_n[4]}]
set_property -dict {PACKAGE_PIN E18 IOSTANDARD LVDS_25 DIFF_TERM 1} [get_ports {rx_data_in_p[5]}]
set_property -dict {PACKAGE_PIN E19 IOSTANDARD LVDS_25 DIFF_TERM 1} [get_ports {rx_data_in_n[5]}]
set_property -dict {PACKAGE_PIN N20 IOSTANDARD LVDS_25} [get_ports tx_clk_out_p]
set_property -dict {PACKAGE_PIN P20 IOSTANDARD LVDS_25} [get_ports tx_clk_out_n]
set_property -dict {PACKAGE_PIN W14 IOSTANDARD LVDS_25} [get_ports tx_frame_out_p]
set_property -dict {PACKAGE_PIN Y14 IOSTANDARD LVDS_25} [get_ports tx_frame_out_n]
set_property -dict {PACKAGE_PIN N15 IOSTANDARD LVDS_25} [get_ports {tx_data_out_p[0]}]
set_property -dict {PACKAGE_PIN N16 IOSTANDARD LVDS_25} [get_ports {tx_data_out_n[0]}]
set_property -dict {PACKAGE_PIN V15 IOSTANDARD LVDS_25} [get_ports {tx_data_out_p[1]}]
set_property -dict {PACKAGE_PIN W15 IOSTANDARD LVDS_25} [get_ports {tx_data_out_n[1]}]
set_property -dict {PACKAGE_PIN U13 IOSTANDARD LVDS_25} [get_ports {tx_data_out_p[2]}]
set_property -dict {PACKAGE_PIN V13 IOSTANDARD LVDS_25} [get_ports {tx_data_out_n[2]}]
set_property -dict {PACKAGE_PIN V12 IOSTANDARD LVDS_25} [get_ports {tx_data_out_p[3]}]
set_property -dict {PACKAGE_PIN W13 IOSTANDARD LVDS_25} [get_ports {tx_data_out_n[3]}]
set_property -dict {PACKAGE_PIN Y16 IOSTANDARD LVDS_25} [get_ports {tx_data_out_p[4]}]
set_property -dict {PACKAGE_PIN Y17 IOSTANDARD LVDS_25} [get_ports {tx_data_out_n[4]}]
set_property -dict {PACKAGE_PIN J18 IOSTANDARD LVDS_25} [get_ports {tx_data_out_p[5]}]
set_property -dict {PACKAGE_PIN H18 IOSTANDARD LVDS_25} [get_ports {tx_data_out_n[5]}]

set_property -dict {PACKAGE_PIN Y18 IOSTANDARD LVCMOS25} [get_ports {gpio_status[0]}]
set_property -dict {PACKAGE_PIN Y19 IOSTANDARD LVCMOS25} [get_ports {gpio_status[1]}]
set_property -dict {PACKAGE_PIN K14 IOSTANDARD LVCMOS25} [get_ports {gpio_status[2]}]
set_property -dict {PACKAGE_PIN J14 IOSTANDARD LVCMOS25} [get_ports {gpio_status[3]}]
set_property -dict {PACKAGE_PIN T17 IOSTANDARD LVCMOS25} [get_ports {gpio_status[4]}]
set_property -dict {PACKAGE_PIN R18 IOSTANDARD LVCMOS25} [get_ports {gpio_status[5]}]
set_property -dict {PACKAGE_PIN V20 IOSTANDARD LVCMOS25} [get_ports {gpio_status[6]}]
set_property -dict {PACKAGE_PIN W20 IOSTANDARD LVCMOS25} [get_ports {gpio_status[7]}]
set_property -dict {PACKAGE_PIN F19 IOSTANDARD LVCMOS25} [get_ports {gpio_ctl[0]}]
set_property -dict {PACKAGE_PIN F20 IOSTANDARD LVCMOS25} [get_ports {gpio_ctl[1]}]
set_property -dict {PACKAGE_PIN D19 IOSTANDARD LVCMOS25} [get_ports {gpio_ctl[2]}]
set_property -dict {PACKAGE_PIN D20 IOSTANDARD LVCMOS25} [get_ports {gpio_ctl[3]}]
set_property -dict {PACKAGE_PIN L14 IOSTANDARD LVCMOS25} [get_ports gpio_en_agc]
set_property -dict {PACKAGE_PIN L15 IOSTANDARD LVCMOS25} [get_ports gpio_sync]
set_property -dict {PACKAGE_PIN K19 IOSTANDARD LVCMOS25} [get_ports gpio_resetb]
set_property -dict {PACKAGE_PIN T20 IOSTANDARD LVCMOS25} [get_ports enable]
set_property -dict {PACKAGE_PIN U20 IOSTANDARD LVCMOS25} [get_ports txnrx]

set_property PACKAGE_PIN W18 [get_ports spi_csn]
set_property IOSTANDARD LVCMOS25 [get_ports spi_csn]
set_property PULLUP true [get_ports spi_csn]
set_property -dict {PACKAGE_PIN W19 IOSTANDARD LVCMOS25} [get_ports spi_clk]
set_property -dict {PACKAGE_PIN V16 IOSTANDARD LVCMOS25} [get_ports spi_mosi]
set_property -dict {PACKAGE_PIN W16 IOSTANDARD LVCMOS25} [get_ports spi_miso]

# clocks

create_clock -period 4.000 -name rx_clk [get_ports rx_clk_in_p]


set_property CLOCK_DEDICATED_ROUTE FALSE [get_nets i_system_wrapper/system_i/axi_ad9361/inst/i_dev_if/i_clk/clk_ibuf_s]


set_property BITSTREAM.GENERAL.COMPRESS TRUE [current_design]
